Saiesh0007/3DP/Parts.PNG

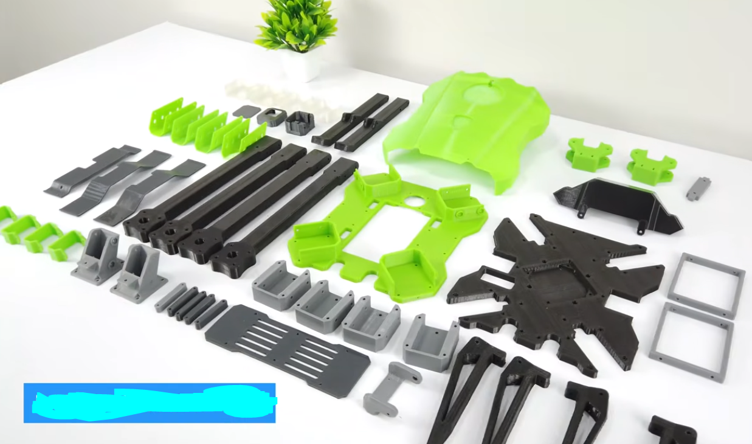
Parts.PNG
