Saiesh0007/3DP/version 6/output/renders/front_corridor.png

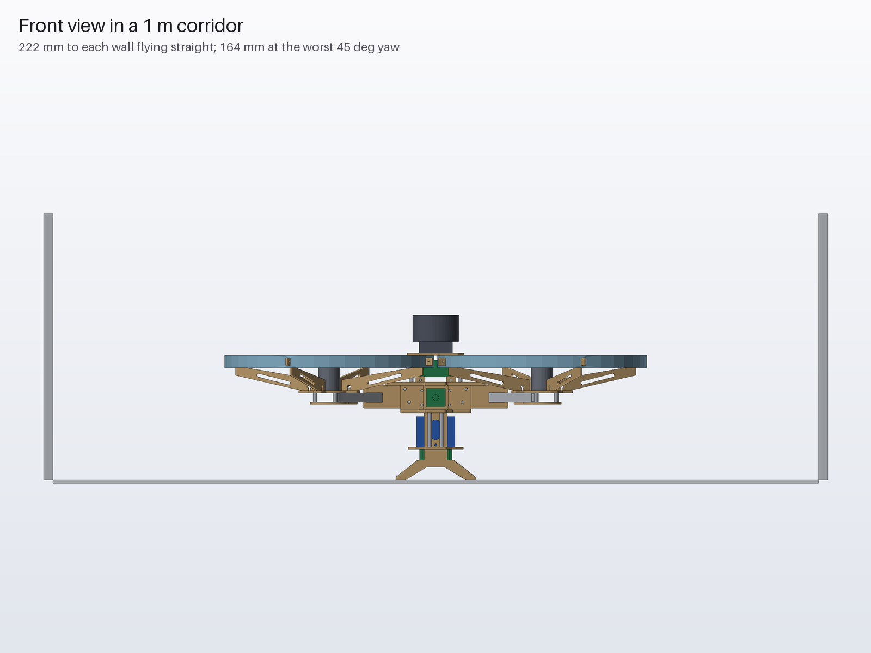
version 6/output/renders/front_corridor.png
