Saiesh0007/3DP/version 2/README.md

# NIDAR AirMouse frame, version 2

Original design for Mission 2 (AirMouse), generated by `generate_frame.py`. Arms fold downward. It is built around a Pixhawk 2.4.8, Raspberry Pi 4B, YDLidar X2, TFmini-S, PX4Flow, Readytosky 2212 920 KV motors, 40 A ESCs and a CNHL 3S 5000 mAh battery.

**Status: not yet printed or flown.** The checks below cover geometry and estimates only. Do the thrust test first: it decides whether this motor and battery setup can carry the drone.

## Rule check

| Rule | Limit | This design |
|---|---|---|
| Launch area (Rulebook 8.23, Brief 9) | 2 ft × 2 ft (610 mm) | 560 mm wide, 49 mm spare |
| Corridor (8.22) | 1 m wide, 8 ft high | 220 mm each side square on; 161 mm each side at the worst 45° yaw |
| Room (8.22) | 2 m × 2 m | Worst-case rotation width is 677 mm |
| All-up weight (Brief 2) | 10 kg | About 2.2 kg |
| Prop guards (8.30) | "fully protect the propeller operating area" | Full ring around each prop. **No top or bottom mesh, so confirm this is accepted** |
| Original airframe (8.2, 10.8) | No ready-made complete airframes | Own design, printed by the team |

Other rules to plan for, which a frame can't solve on its own:

- **Live camera feed (8.27):** your parts list has no camera. The frame has a mount for a Raspberry Pi camera board.
- **Emergency stop and failsafes (8.31):** set these up in the flight software and test them.
- **Fast Completion bonus (25 marks):** the mission must finish within 15 minutes, and the estimated flight time here is about 8.

## Why it can't be much smaller

At 3S, 2212 920 KV motors need 10-inch props to produce useful thrust, and smaller props lift less. Each guard needs 8 mm of clearance around the prop, and the guards can't overlap, so that sets the minimum size.

| | Width, square on | Width at worst yaw | Clearance per side at worst yaw |
|---|---|---|---|
| This frame, 10 in props | 560 mm | 677 mm | 161 mm |
| F450 with the same guards (calculated) | 597 mm | 729 mm | 136 mm |

## The main risk: thrust

| Item | Estimate |
|---|---|
| Printed frame | About 730 g (880 g at most) |
| Your parts, wiring, bolts | About 1470 g |
| All-up weight | About 2.2 kg |
| Thrust-to-weight | **1.17 to 1.55** (aim for 2.0; below about 1.5 is risky) |
| Hover flight time | **About 8 minutes** (80% of battery used) |

The thrust range comes from published figures for this motor size that disagree: a test table gives 642 g per motor on a 1045 prop at 11.1 V, and seller listings claim 850 g or more. The Readytosky motors have no maker's test data that I could find.

**Test before printing the full set.** Measure one motor with a 1045 prop, your ESC and a charged battery, using a kitchen scale and a secured motor. Keep clear of the prop.

| Measured thrust per motor | What it means |
|---|---|
| Under 700 g | Thrust-to-weight is under about 1.3. Don't fly this setup. Change the motors or battery |
| 700-850 g | Marginal. Fly slowly and cut weight |
| Over 850 g | Thrust-to-weight is at least about 1.55. Usable indoors, and more is better |

Ways to improve it:

1. Use stronger motors or a higher-voltage battery. This has the biggest effect, and 4S with smaller props could also shrink the frame, but needs its own thrust test.
2. Weigh your lidar: the datasheet says 200 g, while another listing says 126 g.
3. Drop the upper deck height (`POST_H`) if your wiring allows.

## Parts to print

All parts fit the Ender 3 V3 SE and need no supports. Keep each STL in the position it loads in.

| STL | Qty | Size (mm) | Put on the bed |
|---|---|---|---|
| `arm_A_x2.stl` | 2 | 123 × 119 × 32 | Motor face down |
| `arm_B_x2.stl` | 2 | 123 × 119 × 32 | Motor face down |
| `bottom_deck_x1.stl` | 1 | 181 × 162 × 44 | Flat side down |
| `top_deck_x1.stl` | 1 | 180 × 106 × 3 | Flat |
| `upper_deck_x1.stl` | 1 | 100 × 80 × 63 | Flat, posts up |
| `sensor_mount_x1.stl` | 1 | 108 × 48 × 5 | Flat, recess up |
| `leg_x4.stl` | 4 | 97 × 75 × 16 | Flat, flange up |
| `camera_mount_x1.stl` | 1 | 28 × 28 × 14 | Flat, flange up |
| `guard_arc_x16.stl` | 16 | 42 × 192 × 20 | Standing on its rim |
| `guard_spoke_x16.stl` | 16 | 117 × 48 × 20 | Flat, flanges up |

Arm A goes at front left and rear right. Arm B goes at front right and rear left.

## Slicer settings

| Setting | Arms, bottom deck | Guards | Everything else |
|---|---|---|---|
| Material | PETG | PETG | PETG |
| Layer height | 0.2 mm | 0.2 mm | 0.2 mm |
| Walls | 5 lines | 3 lines | 4 lines |
| Infill | 30% gyroid | 100% | 30% gyroid |
| Supports | Off | Off | Off |
| Brim | 5 mm on arms | 5 mm on arcs | Only if corners lift |

## Hardware

| Use | Hardware | Qty |
|---|---|---|
| Arm hinge and lock | M4 × 35 + nyloc nut | 8 |
| Deck bolts | M3 × 50 + plain nut with threadlocker (the stack is 46.6 mm, too long for a nyloc on a 50 mm bolt) | 12 |
| Upper deck posts | M3 × 70 + nyloc nut | 4 |
| Legs | M3 × 12 + washer + nyloc nut | 8 |
| Guard spoke to arm | M3 × 10 + nyloc nut | 32 |
| Guard arc to spoke | M3 × 10 + nut | 32 |
| Motors | M3, 4 per motor, short enough to stop clear of the windings | 16 |
| Sensor mount | M3 × 10 + nyloc nut | 4 |
| Camera mount | M3 × 10 + nut | 2 |
| YDLidar X2 | M2.5, length to suit its standoffs | 3 |
| Raspberry Pi | M2.5 × 8 | 4 |
| TFmini-S | M2 × 8 | 2 |
| PX4Flow, Pixhawk | Zip ties, foam tape | |

## Where each part goes

| Part | Location |
|---|---|
| Battery | In the bay, on a 3 mm foam pad. Strap through the deck slots |
| Pixhawk 2.4.8 | Centre of the top deck, on anti-vibration foam, with zip-tie slots around it |
| Raspberry Pi 4B | Under the upper deck, on the built-in standoffs |
| YDLidar X2 | On top of the upper deck. Scan plane about 152 mm above the deck, 69 mm above the guards |
| TFmini-S | Sensor mount, rear position, lenses down |
| PX4Flow | Sensor mount, front position, in the recess, lens down, held by zip ties |
| ESCs | On top of each arm, zip-tied |
| Camera | Front of the top deck, facing forward |

Enter the true sensor positions in the flight controller settings, because the sensors sit off-centre. The TFmini-S can't read below 10 cm, and sits about 54 mm off the ground when landed, so its reading is invalid until the drone climbs. Set the flight controller's minimum-range setting to match.

## Folding

1. Remove the lock bolt on each arm (the upper, outer bolt). Leave the hinge bolt in.
2. Swing the arm down.
3. To open, swing it up until it stops against the wall, then refit the lock bolt.

Folded size is 554 × 272 × 312 mm. Leave enough wire slack at each hinge for 90° of movement, or the wires will fatigue. Check all four lock bolts before every flight.

Thrust pushes the arm against a solid stop wall, so the lock bolt doesn't carry flight loads. It stops the arm folding on the ground or in a bump.

## Measure these before printing the full set

| Item | Assumed | Source | Parameter |
|---|---|---|---|
| Motor bolt holes | 16 mm and 19 mm | Common for this motor type, not confirmed for yours | `MOTOR_HOLES` |
| Pad top to prop height | 38 mm | Estimate; the guard band allows about ±8 mm | `PROP_Z_ABOVE_PAD` |
| Battery size | Up to 165 × 50 × 38 mm | No published size found for your pack | `BATTERY` |
| PX4Flow | 45.5 × 35 mm; lens at centre | PX4 docs for size; hole spacing not found, so it uses zip ties | `PX4FLOW` |
| X2 scan height | 42 mm above its base | Scaled from the datasheet drawing | `X2_SCAN_ABOVE_BASE` |
| ESC, prop, flow, wiring masses | See `MASSES` | Assumed | `MASSES` |

Pixhawk size came from retailer listings that vary slightly (width 45.3 to 50 mm). X2 hole positions and TFmini-S spacing come from their datasheet drawings.

## Check results

Run `python generate_frame.py` for current results. All checks pass:

- All 10 STLs are watertight when re-read from disk, and fit the bed.
- Arms, guards and motors clear each other, the body and the legs, deployed, folded and at 9 positions through the fold with all four arms moving together.
- The arm can't rotate upward past its stop wall.
- 10 inch props clear the guards, arms and body.
- The X2 scan plane is above the guards and motors, and the downward sensors see past the legs.
- Hinge, leg, deck, sensor, camera and guard bolt holes line up.

Not modelled or tested: real strength, layer adhesion, vibration, crash loads, airflow under the deck, and thrust lost near the guards. The camera lens view, wiring routes and bolt heads aren't checked either.

## Test order

1. Thrust test on one motor (see above).
2. Print one arm A, one guard set and the bottom deck. Check fit, hinge motion and lock bolt.
3. Clamp the deck and hang 2 kg from the motor pad for 5 minutes. Look for cracks or bending.
4. Print the rest. Weigh everything and update `MASSES`.
5. Run motors with props off, and check for loose bolts.
6. Tie the drone down loosely for a first hover test in an open space with a tested emergency stop. Check the vibration logs, especially for the X2 on its tall posts.

Rule 8.5 bans tethers during the mission itself; a tether is only for your own testing.
