Saiesh0007/3DP/Folded.PNG

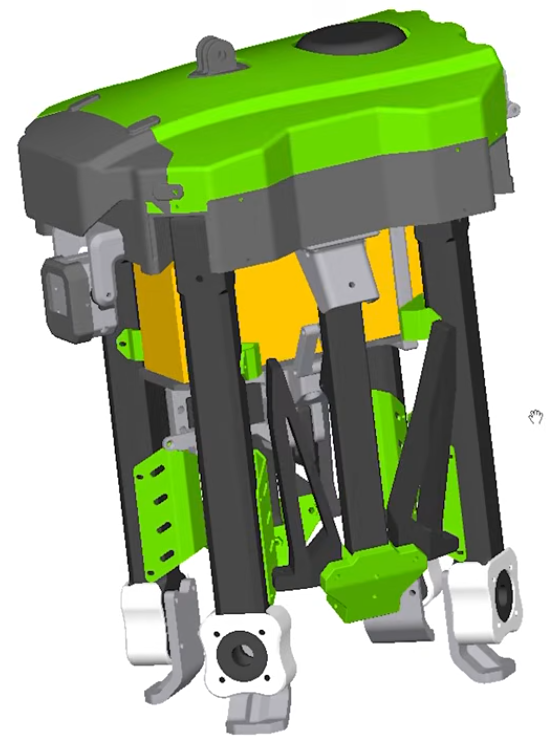
Folded.PNG
