Saiesh0007/3DP/Front View 2.PNG

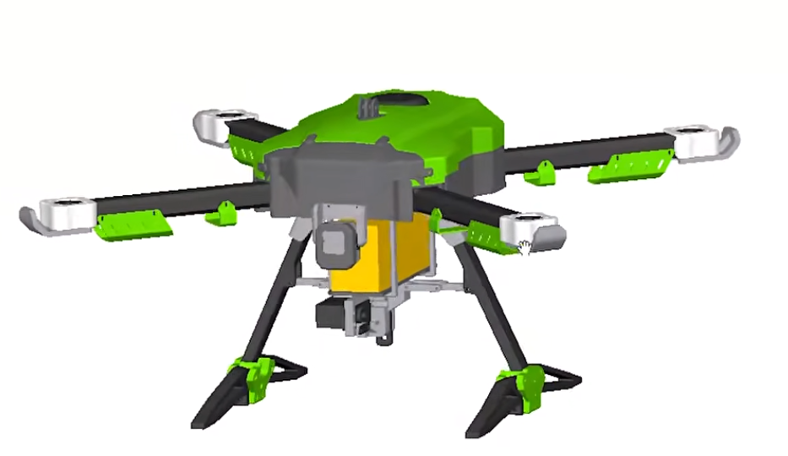
Front View 2.PNG
