Saiesh0007/3DP/Front View.PNG

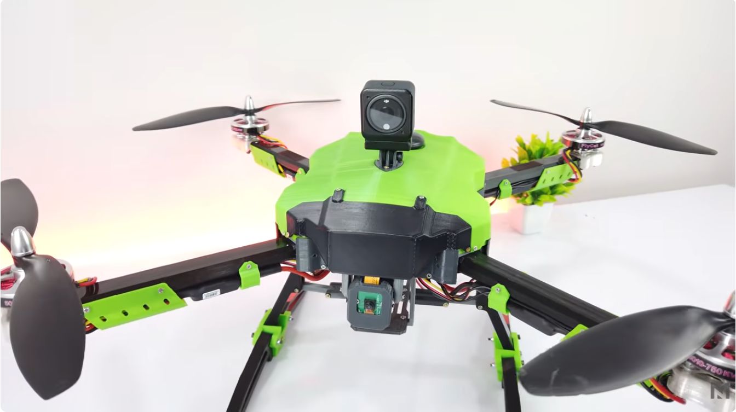
Front View.PNG
