Saiesh0007/3DP/Top View 2.PNG

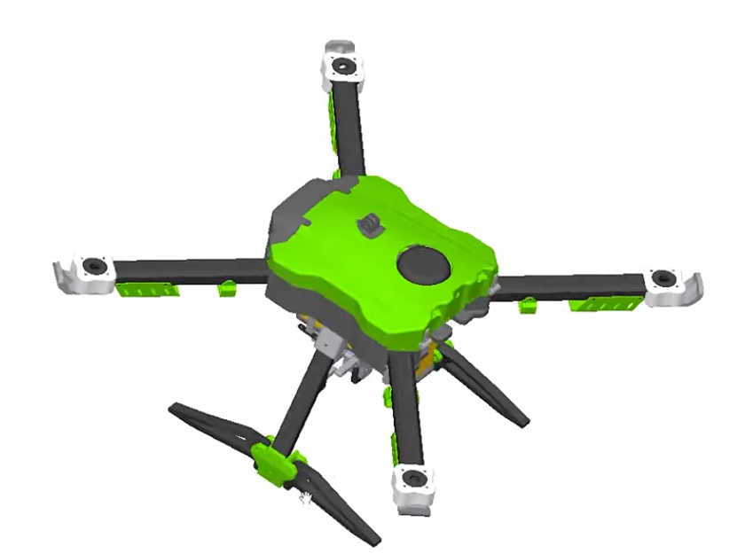
Top View 2.PNG
