Saiesh0007/3DP/Top View.PNG

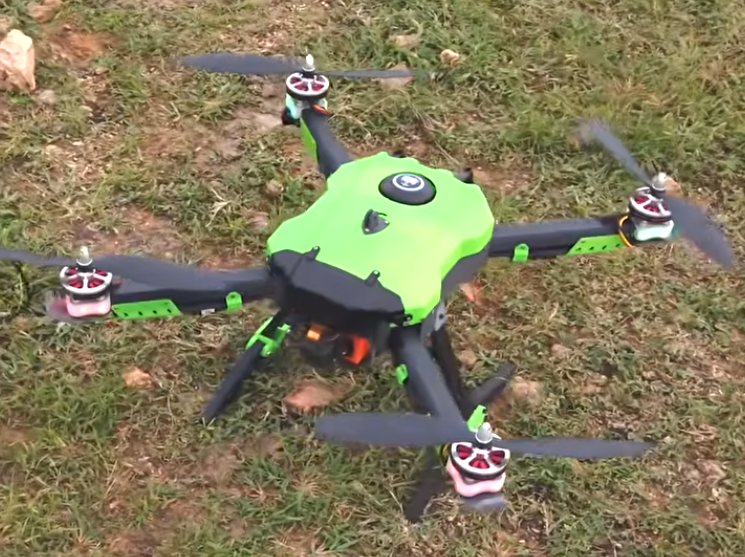
Top View.PNG
