Saiesh0007/3DP/version 6/output/renders/arm_hinge.png

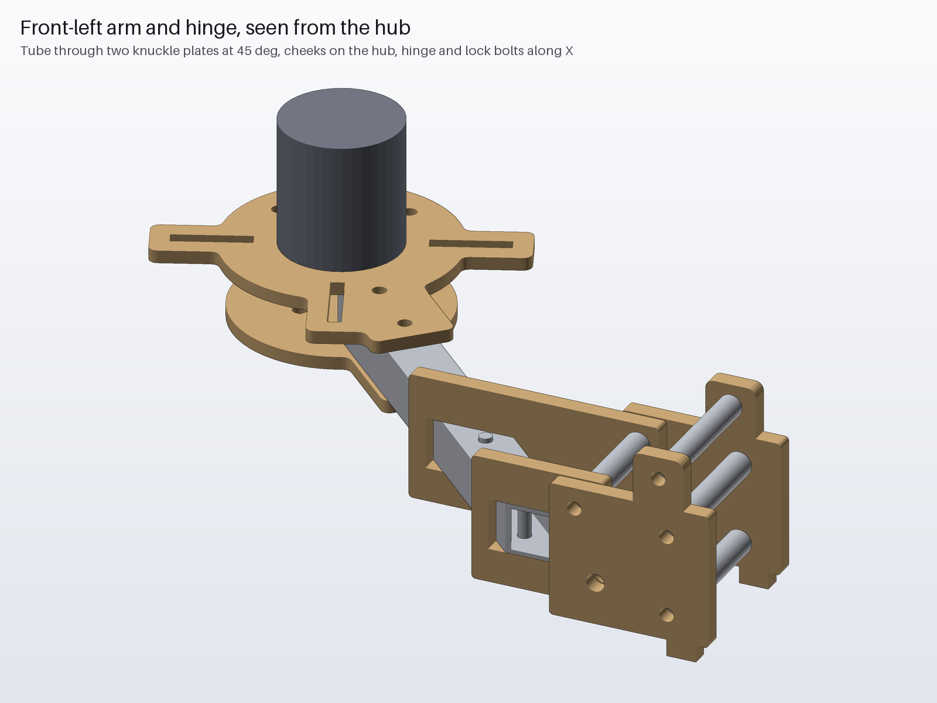
version 6/output/renders/arm_hinge.png
