Saiesh0007/3DP/version 6/output/renders/cut_sheet_3mm.png

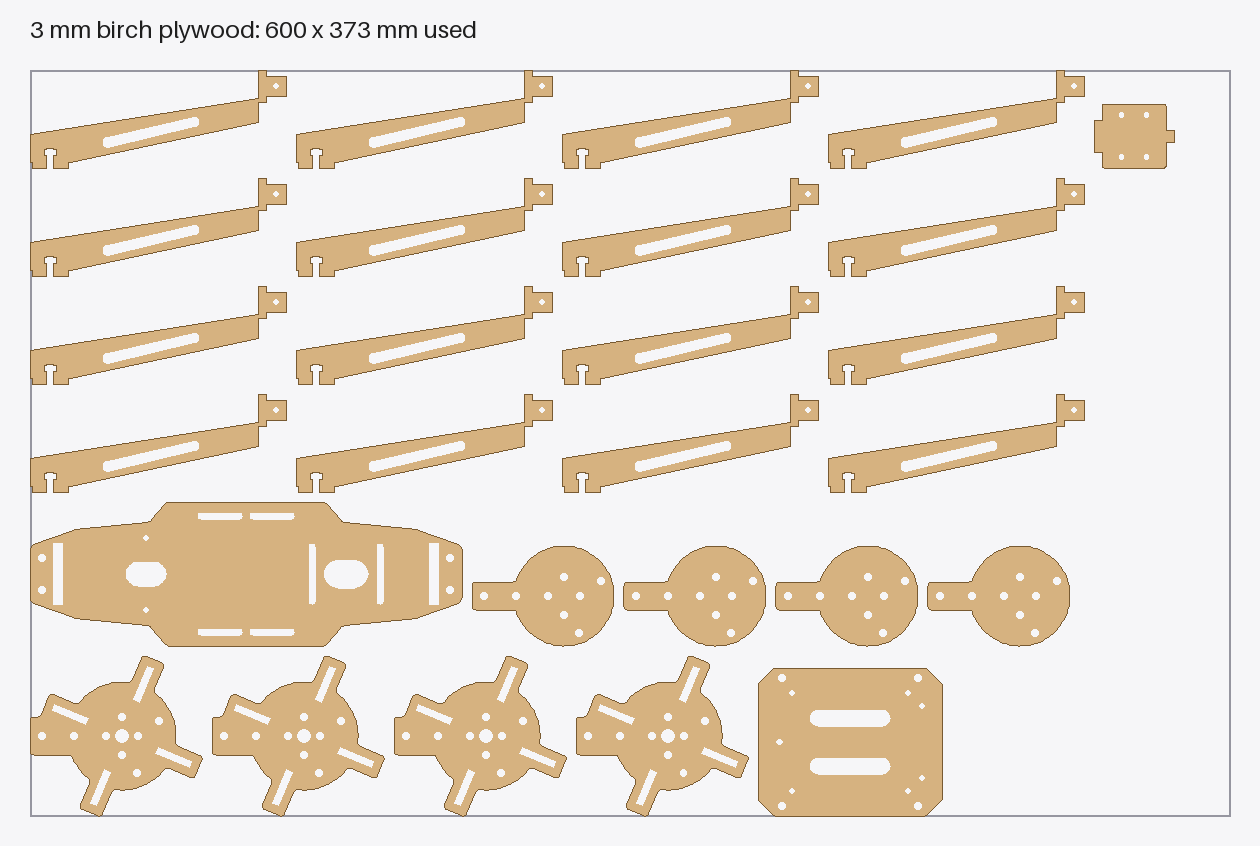
version 6/output/renders/cut_sheet_3mm.png
