Saiesh0007/3DP/version 6/output/renders/cut_sheet_4mm.png

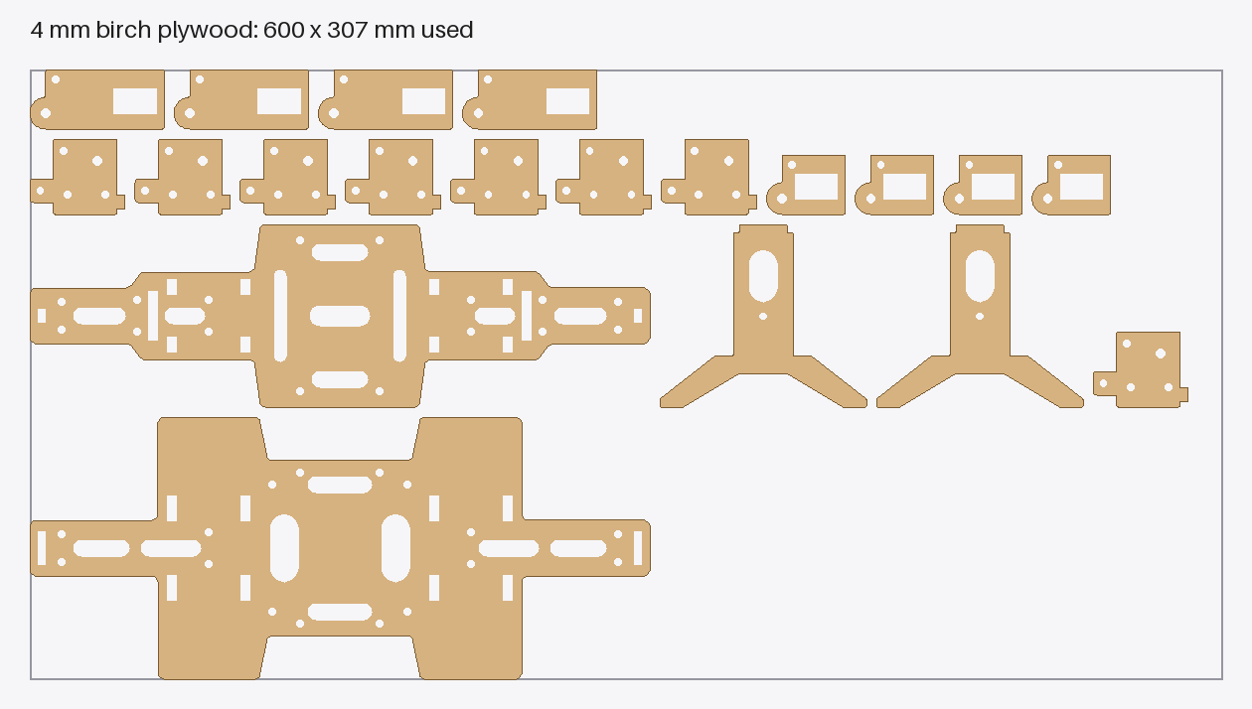
version 6/output/renders/cut_sheet_4mm.png
