Saiesh0007/3DP/version 6/output/renders/deployed.png

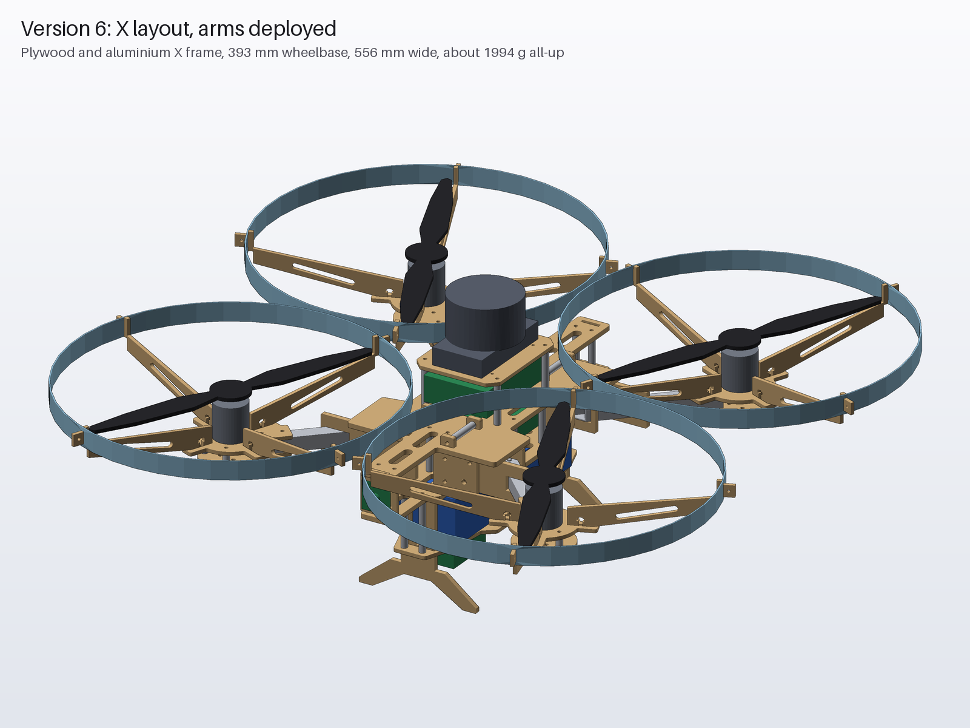
version 6/output/renders/deployed.png
