Saiesh0007/3DP/version 6/output/renders/exploded.png

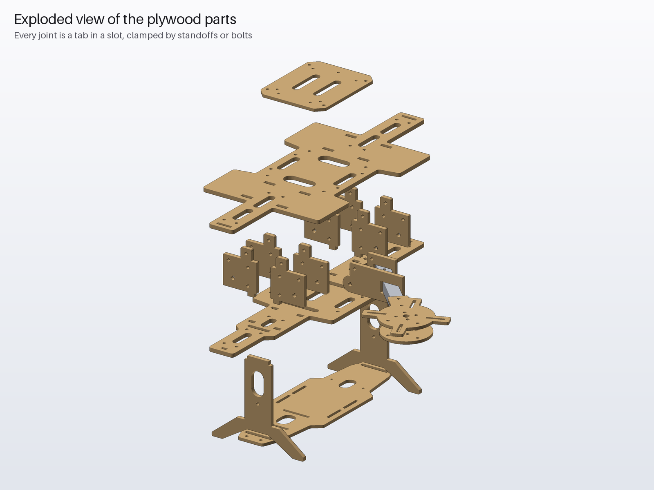
version 6/output/renders/exploded.png
