Saiesh0007/3DP/version 6/output/renders/fold_sequence.png

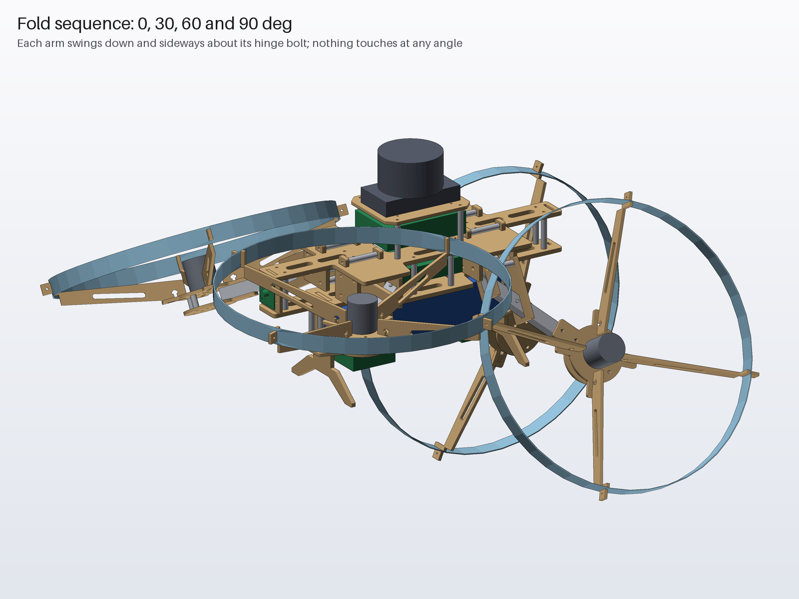
version 6/output/renders/fold_sequence.png
