Saiesh0007/3DP/version 6/output/renders/folded.png

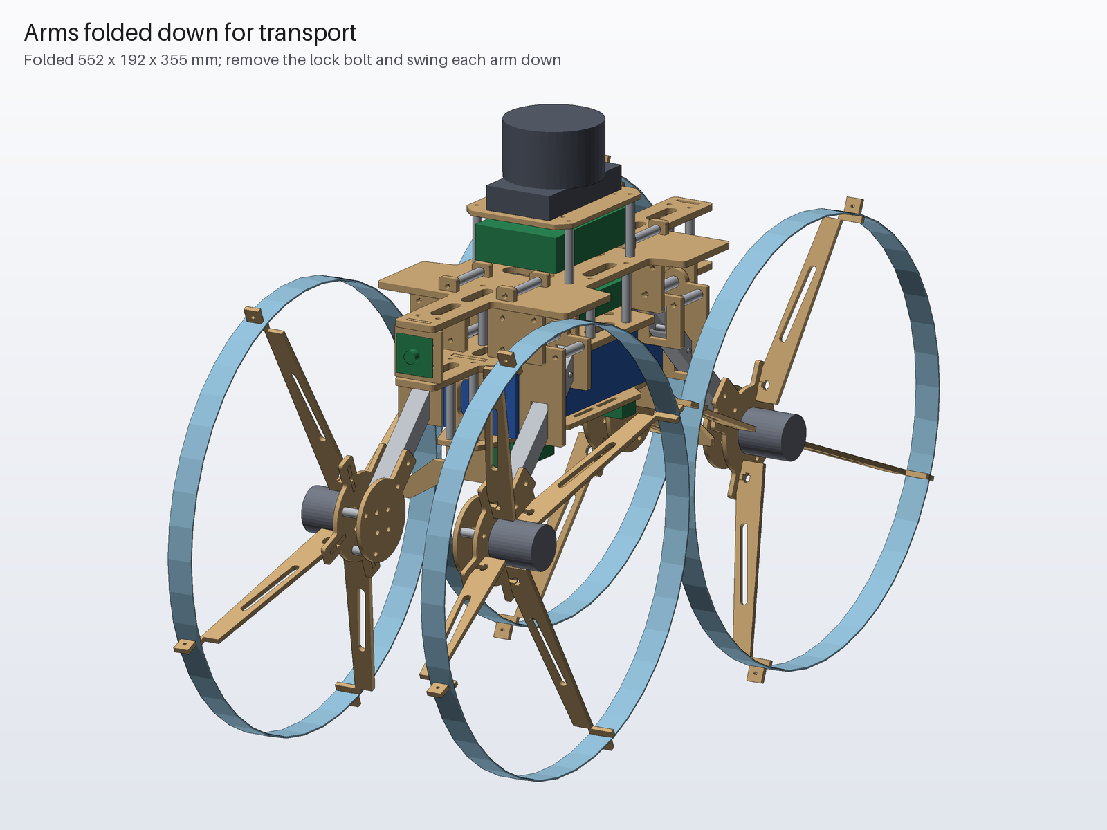
version 6/output/renders/folded.png
