Saiesh0007/3DP/version 6/output/renders/top.png

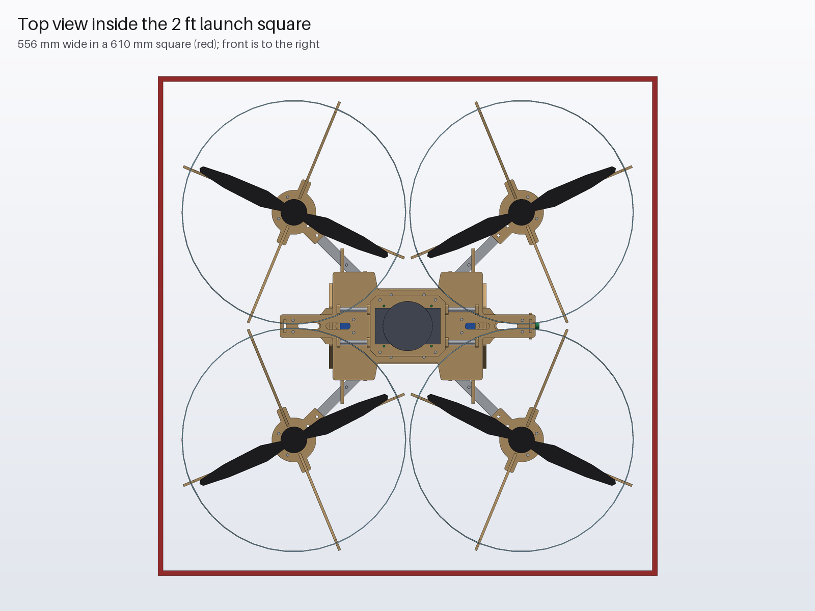
version 6/output/renders/top.png
