Saiesh0007/3DP/version 6/output/step/assembly_folded.step

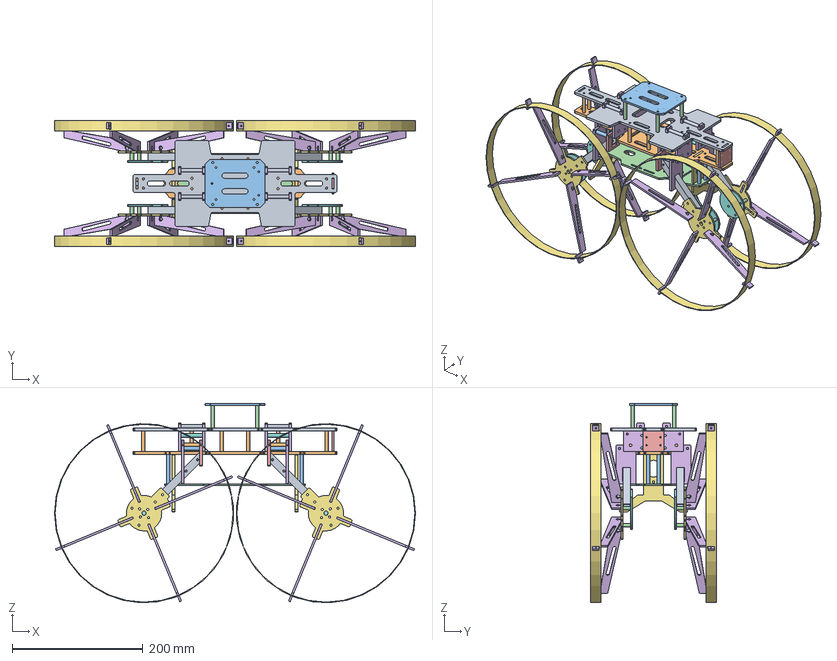
[picture p16: CAD file, 2026-11-10]
version 6/output/step/assembly_folded.step
552.0 x 192.0 x 304.8 mm
