Saiesh0007/3DP/version 6/output/step/assembly_deployed.step

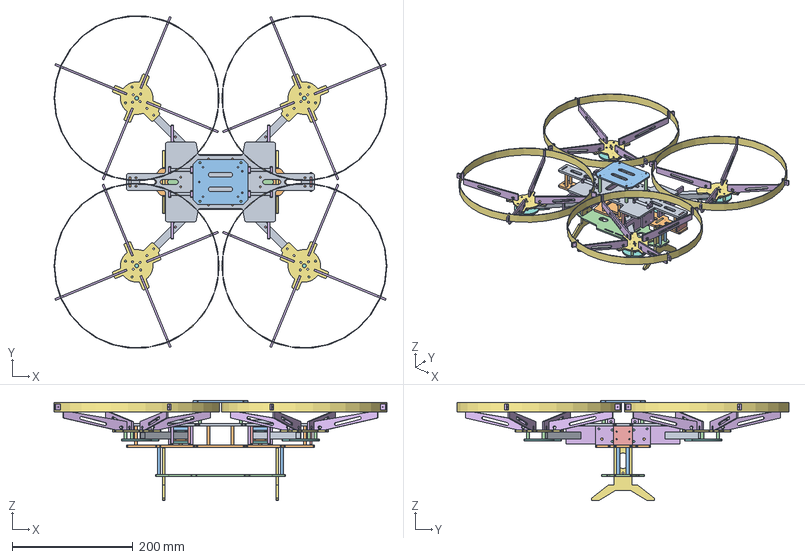
[picture p17: CAD file, 2026-11-10]
version 6/output/step/assembly_deployed.step
552.0 x 550.5 x 166.0 mm
