Saiesh0007/3DP/version 6/output/dxf/CUT_SHEET_4mm.dxf

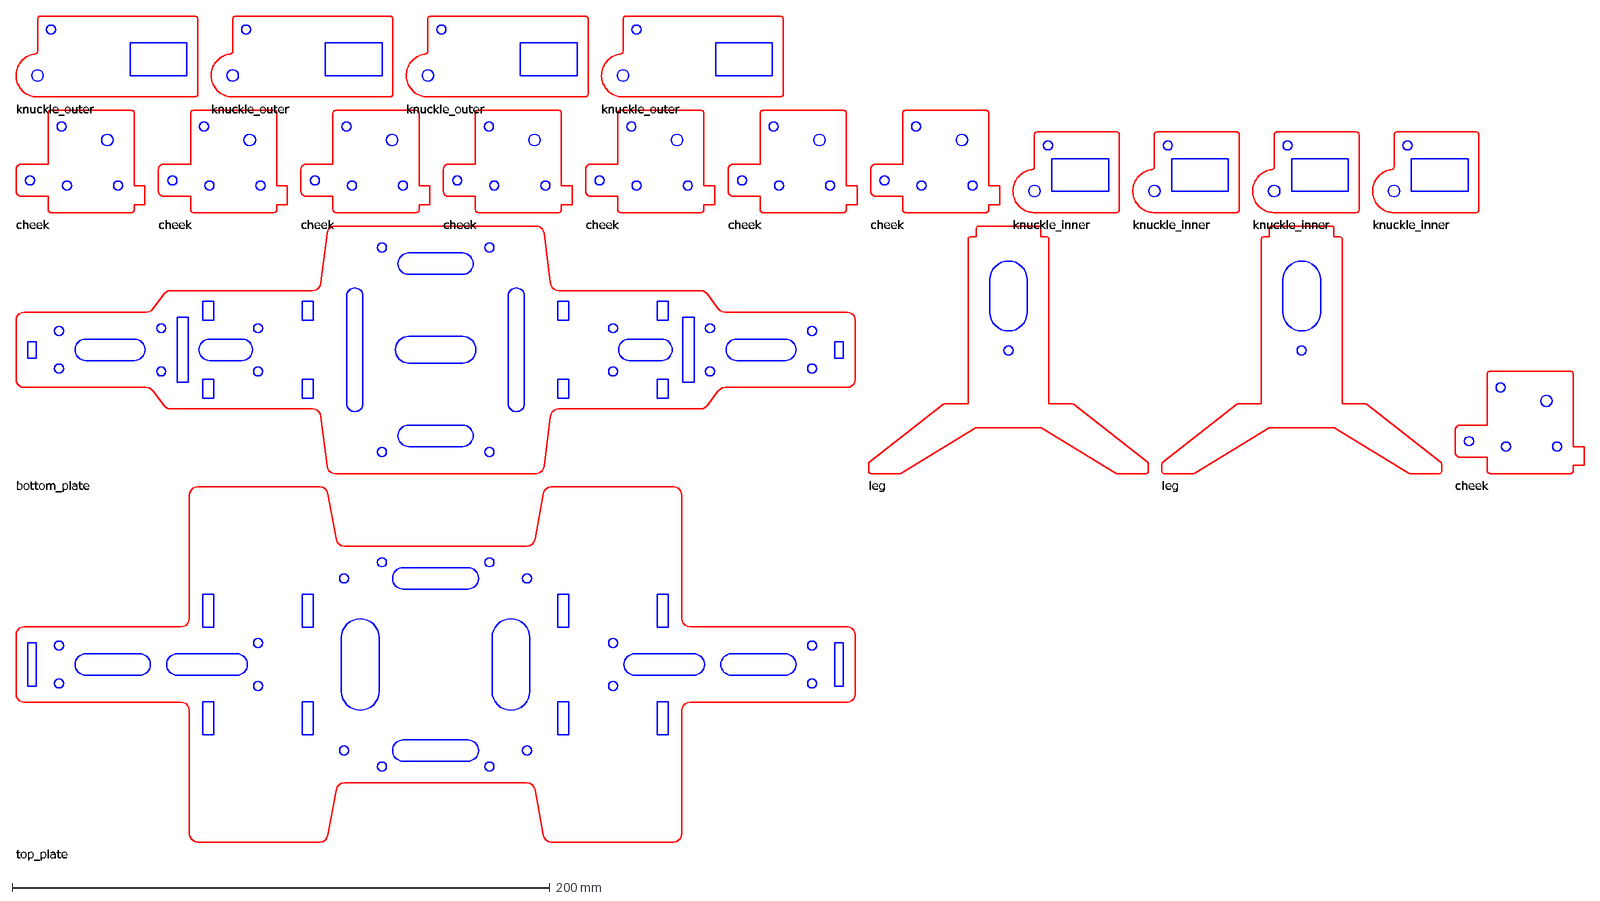
[picture p18: CAD file, 2026-11-10]
version 6/output/dxf/CUT_SHEET_4mm.dxf
top_plate
bottom_plate
leg
cheek
knuckle_inner
knuckle_outer
