Saiesh0007/3DP/version 6/output/step/arm_tube_x4.step

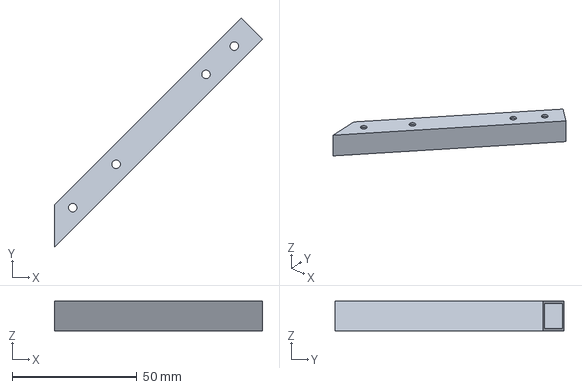
[picture p19: CAD file, 2026-11-10]
version 6/output/step/arm_tube_x4.step
83.3 x 91.8 x 12.0 mm
