Saiesh0007/3DP/version 6/output/dxf/CUT_SHEET_3mm.dxf

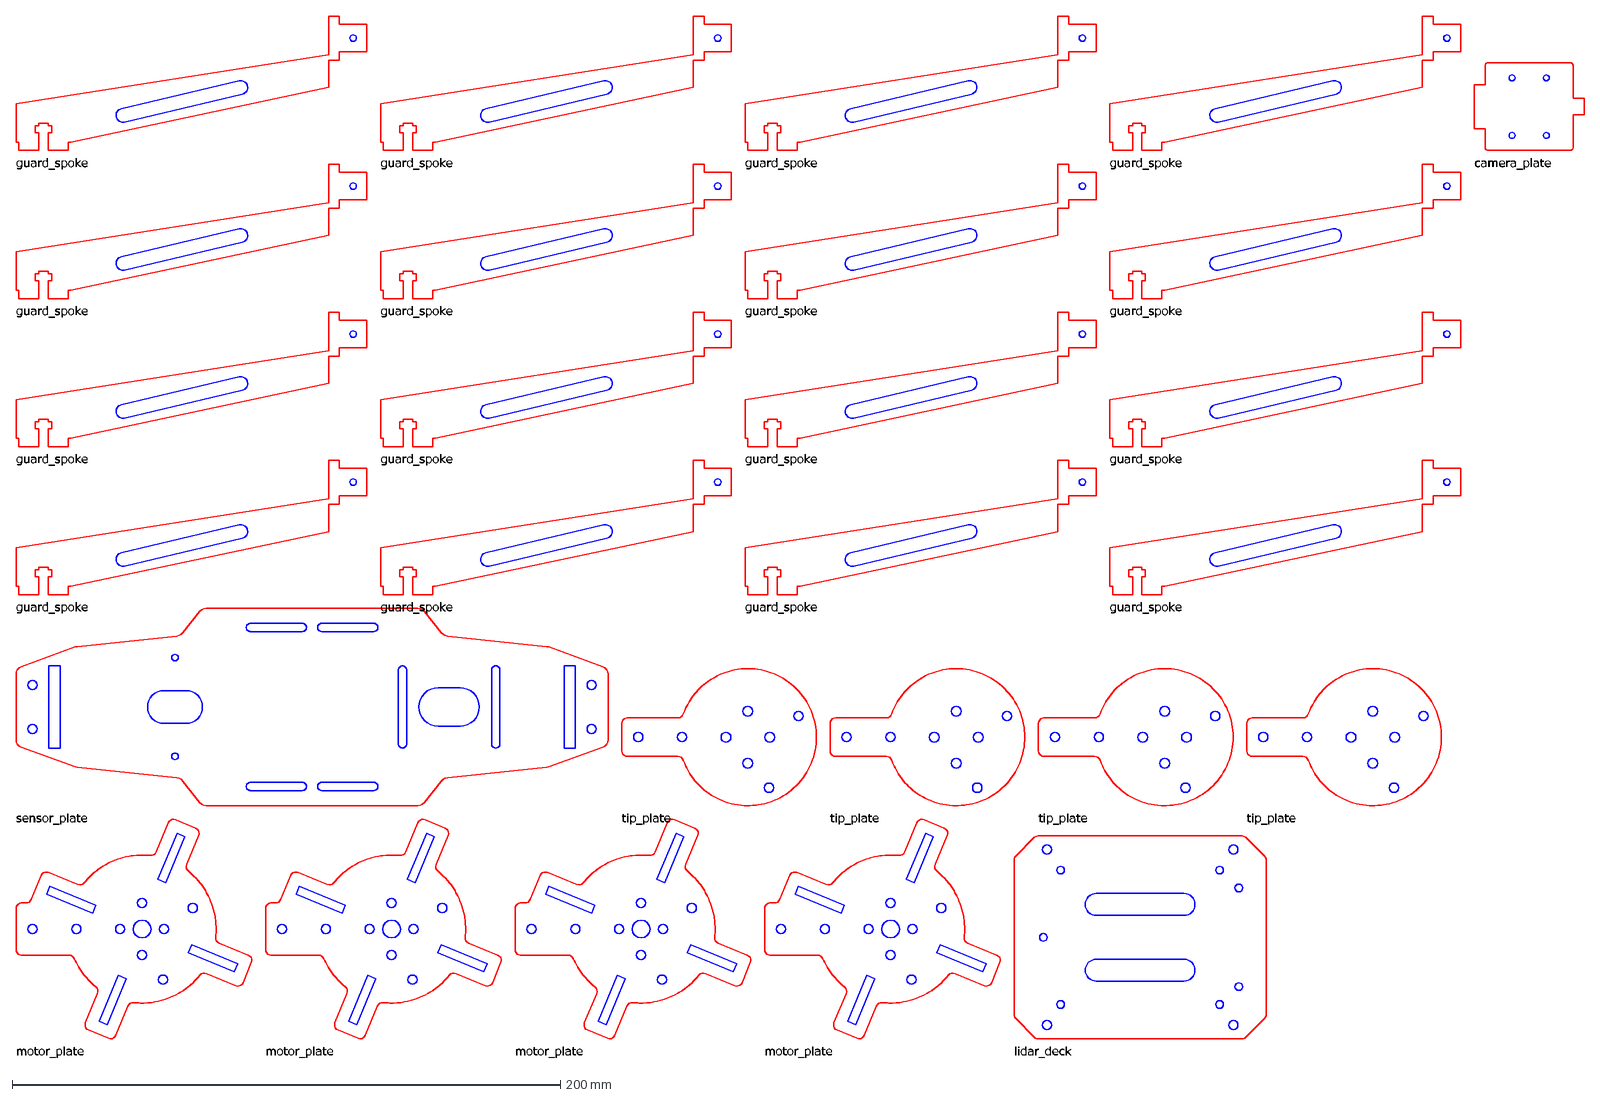
[picture p20: CAD file, 2026-11-10]
version 6/output/dxf/CUT_SHEET_3mm.dxf
motor_plate
lidar_deck
sensor_plate
tip_plate
guard_spoke
camera_plate
