Saiesh0007/3DP/version 6/output/step/lidar_deck_3mm_x1.step

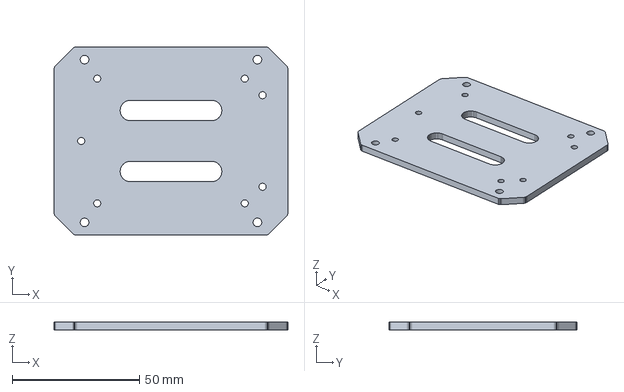
[picture p21: CAD file, 2026-11-10]
version 6/output/step/lidar_deck_3mm_x1.step
92.0 x 74.0 x 3.00 mm
