Saiesh0007/3DP/version 6/output/step/knuckle_outer_4mm_x4.step

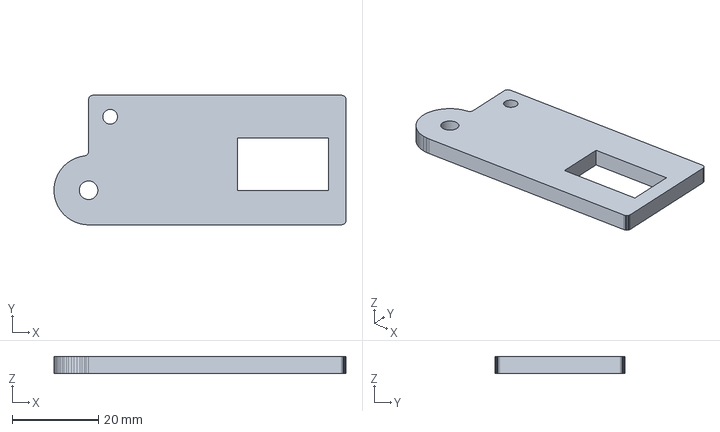
[picture p22: CAD file, 2026-11-10]
version 6/output/step/knuckle_outer_4mm_x4.step
67.6 x 30.0 x 4.00 mm
