Saiesh0007/3DP/version 6/output/step/guard_band_x4.step

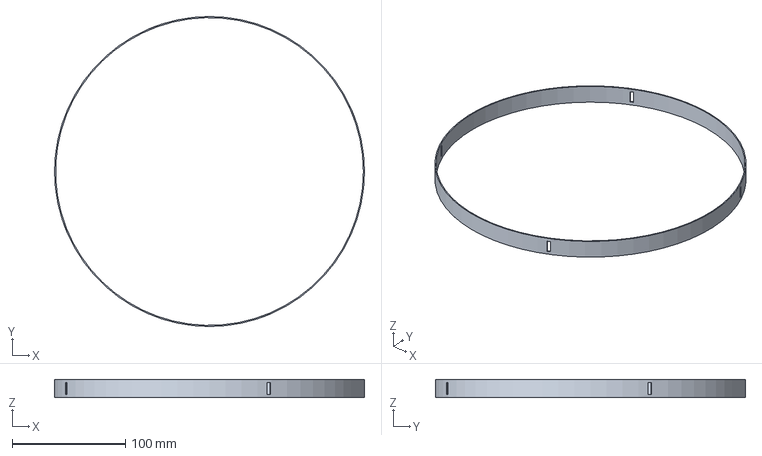
[picture p23: CAD file, 2026-11-10]
version 6/output/step/guard_band_x4.step
274.0 x 274.0 x 16.0 mm
