Saiesh0007/3DP/version 6/output/step/leg_4mm_x2.step

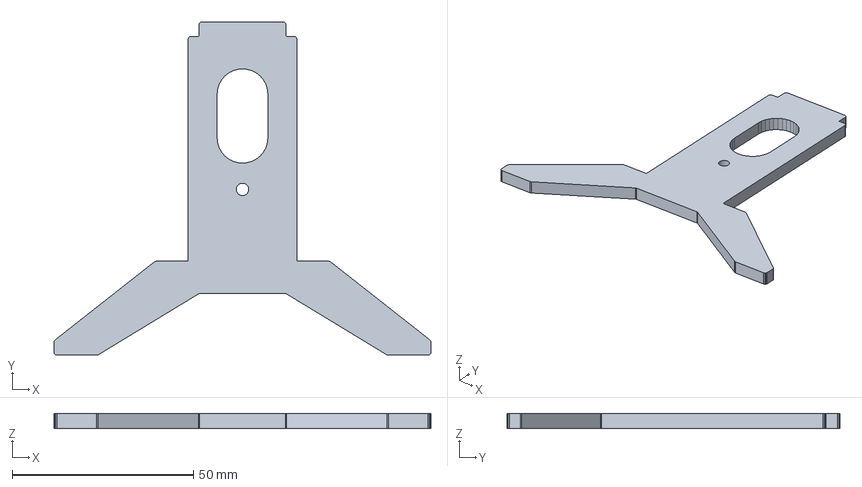
[picture p24: CAD file, 2026-11-10]
version 6/output/step/leg_4mm_x2.step
104.0 x 92.0 x 4.00 mm
