Saiesh0007/3DP/version 6/output/step/tip_plate_3mm_x4.step

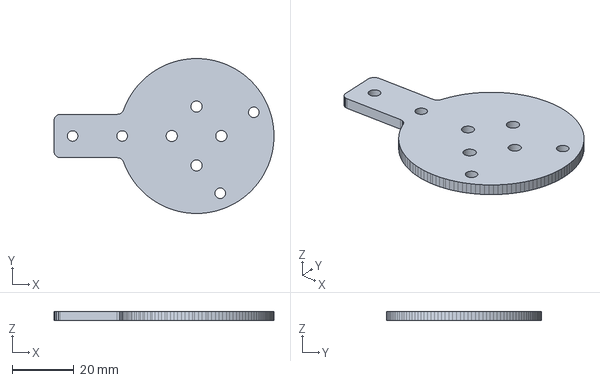
[picture p25: CAD file, 2026-11-10]
version 6/output/step/tip_plate_3mm_x4.step
71.0 x 50.0 x 3.00 mm
