Saiesh0007/3DP/version 6/output/step/guard_spoke_3mm_x16.step

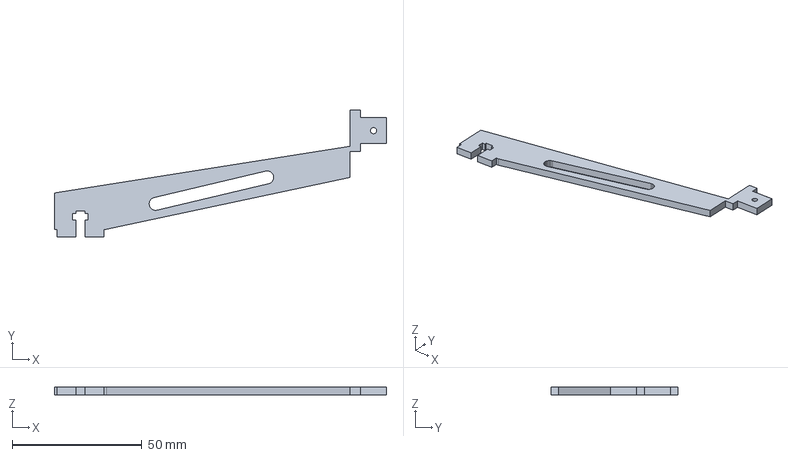
[picture p26: CAD file, 2026-11-10]
version 6/output/step/guard_spoke_3mm_x16.step
128.0 x 49.0 x 3.00 mm
