Saiesh0007/3DP/version 6/output/step/sensor_plate_3mm_x1.step

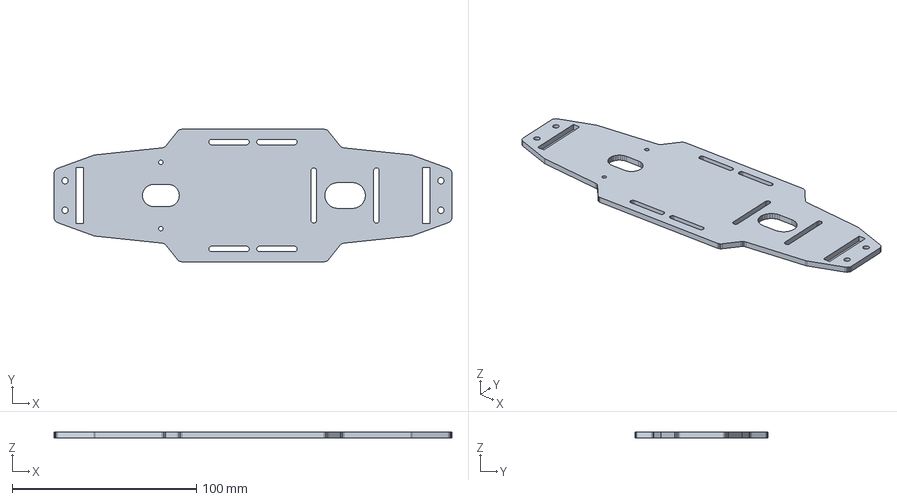
[picture p27: CAD file, 2026-11-10]
version 6/output/step/sensor_plate_3mm_x1.step
216.0 x 72.0 x 3.00 mm
