Saiesh0007/3DP/version 6/output/step/bottom_plate_4mm_x1.step

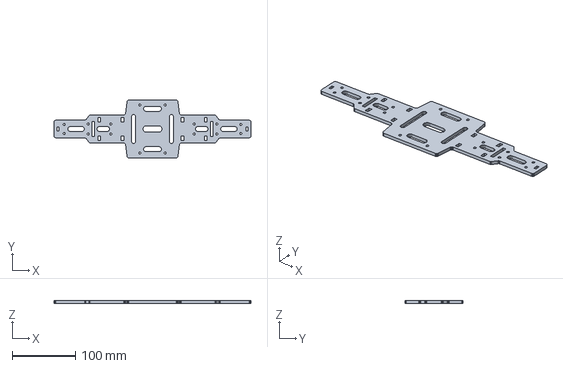
[picture p28: CAD file, 2026-11-10]
version 6/output/step/bottom_plate_4mm_x1.step
312.0 x 92.0 x 4.00 mm
