Saiesh0007/3DP/version 6/output/step/motor_plate_3mm_x4.step

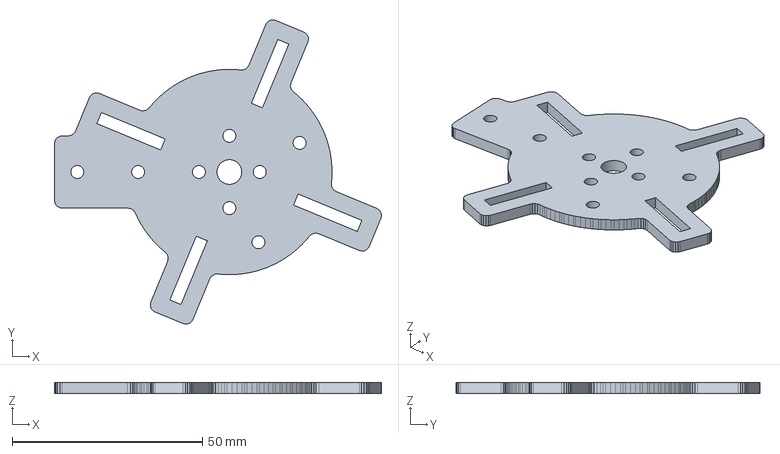
[picture p29: CAD file, 2026-11-10]
version 6/output/step/motor_plate_3mm_x4.step
86.0 x 80.0 x 3.00 mm
