Saiesh0007/3DP/version 6/output/step/top_plate_4mm_x1.step

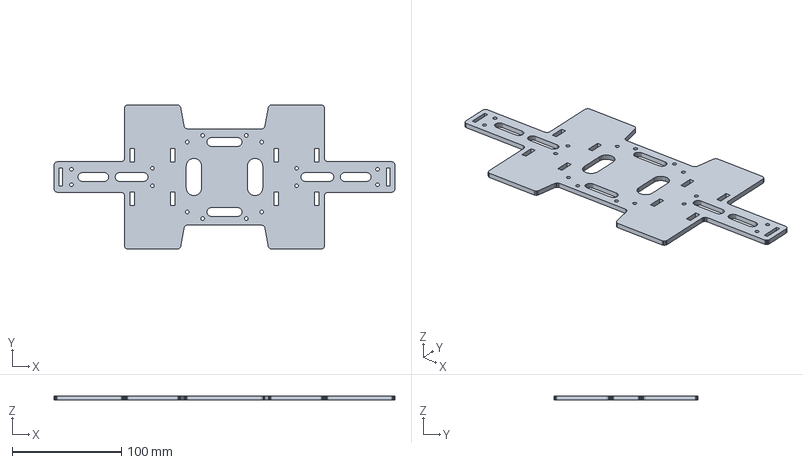
[picture p30: CAD file, 2026-11-10]
version 6/output/step/top_plate_4mm_x1.step
312.0 x 132.0 x 4.00 mm
