Saiesh0007/3DP/version 6/output/step/camera_plate_3mm_x1.step

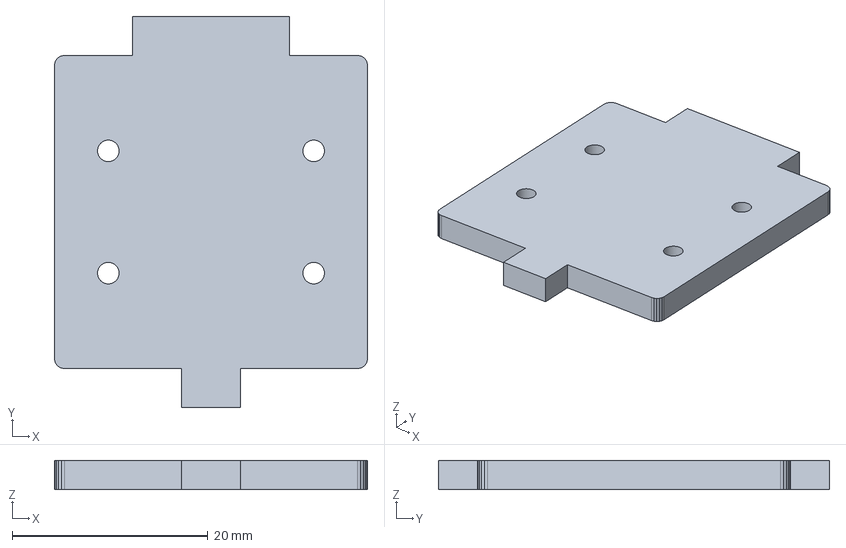
[picture p31: CAD file, 2026-11-10]
version 6/output/step/camera_plate_3mm_x1.step
32.0 x 40.0 x 3.00 mm
