Saiesh0007/3DP/version 6/output/step/cheek_4mm_x8.step

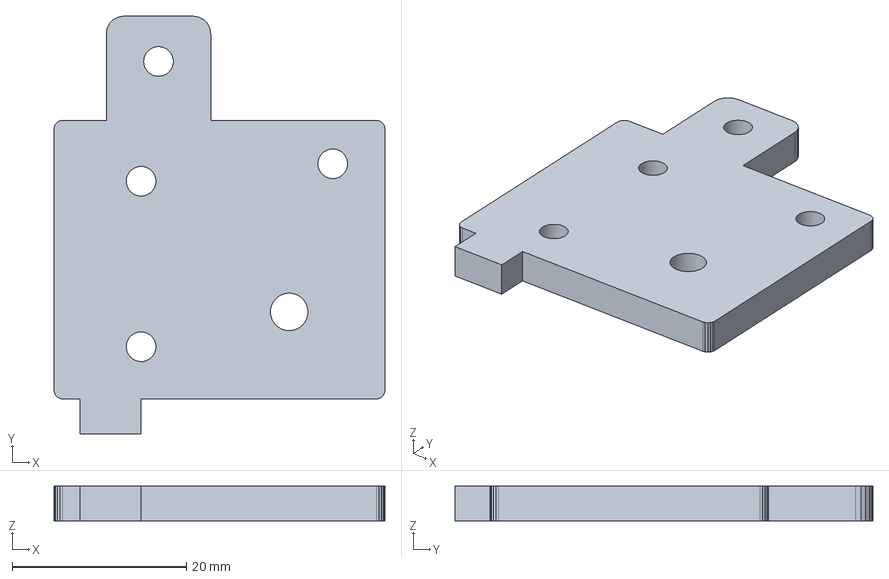
[picture p32: CAD file, 2026-11-10]
version 6/output/step/cheek_4mm_x8.step
38.0 x 48.0 x 4.00 mm
