Saiesh0007/3DP/version 6/output/step/knuckle_inner_4mm_x4.step

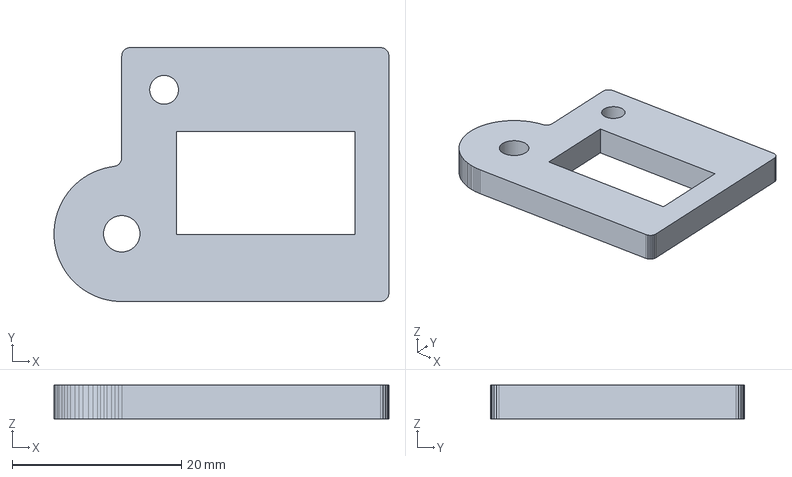
[picture p33: CAD file, 2026-11-10]
version 6/output/step/knuckle_inner_4mm_x4.step
39.6 x 30.0 x 4.00 mm
