Saiesh0007/3DP/(list of files, cad)

Other CAD files:
version 6/output/dxf/guard_band_polycarbonate_x4.dxf
version 1/step/arm_x4.step
version 1/step/assembly_deployed.step
version 1/step/bottom_plate_x1.step
version 1/step/canopy_x1.step
version 1/step/landing_hoop_x2.step
version 1/step/top_plate_x1.step
version 1/stl/arm_x4.stl
version 1/stl/bottom_plate_x1.stl
version 1/stl/canopy_x1.stl
version 1/stl/landing_hoop_x2.stl
version 1/stl/top_plate_x1.stl
version 2/step/arm_A_x2.step
version 2/step/arm_B_x2.step
version 2/step/assembly_deployed.step
version 2/step/bottom_deck_x1.step
version 2/step/camera_mount_x1.step
version 2/step/guard_arc_x16.step
version 2/step/guard_spoke_x16.step
version 2/step/leg_x4.step
version 2/step/sensor_mount_x1.step
version 2/step/top_deck_x1.step
version 2/step/upper_deck_x1.step
version 2/stl/arm_A_x2.stl
version 2/stl/arm_B_x2.stl
version 2/stl/bottom_deck_x1.stl
version 2/stl/camera_mount_x1.stl
version 2/stl/guard_arc_x16.stl
version 2/stl/guard_spoke_x16.stl
version 2/stl/leg_x4.stl
version 2/stl/sensor_mount_x1.stl
version 2/stl/top_deck_x1.stl
version 2/stl/upper_deck_x1.stl
version 3/output/zd550_arm.step
version 3/output/zd550_arm_cut_sheet.dxf
version 3/output/zd550_bottom_plate.dxf
version 3/output/zd550_bottom_plate.step
version 3/output/zd550_motor_mount.dxf
version 3/output/zd550_motor_mount.step
version 3/output/zd550_top_plate.dxf
version 3/output/zd550_top_plate.step
version 4/output/dxf/bottom_plate.dxf
version 4/output/dxf/top_plate.dxf
version 4/output/step/arm_root_A_x2.step
version 4/output/step/arm_root_B_x2.step
version 4/output/step/arm_tube_x4_BUY.step
version 4/output/step/assembly_deployed.step
version 4/output/step/battery_tray_x1.step
version 4/output/step/bottom_plate_x1.step
version 4/output/step/guard_arc_x16.step
version 4/output/step/guard_spoke_x16.step
version 4/output/step/hinge_base_A_x2.step
version 4/output/step/hinge_base_B_x2.step
version 4/output/step/leg_A_x2.step
version 4/output/step/leg_B_x2.step
version 4/output/step/lidar_deck_x1.step
version 4/output/step/motor_mount_x4.step
version 4/output/step/top_plate_x1.step
version 4/output/stl/arm_root_A_x2.stl
version 4/output/stl/arm_root_B_x2.stl
version 4/output/stl/battery_tray_x1.stl
version 4/output/stl/bottom_plate_x1.stl
version 4/output/stl/guard_spoke_x16.stl
version 4/output/stl/hinge_base_A_x2.stl
version 4/output/stl/hinge_base_B_x2.stl
version 4/output/stl/leg_A_x2.stl
version 4/output/stl/leg_B_x2.stl
version 4/output/stl/lidar_deck_x1.stl
version 4/output/stl/motor_mount_x4.stl
version 4/output/stl/top_plate_x1.stl
version 5/output/dxf/CUT_SHEET_2mm.dxf
version 5/output/dxf/CUT_SHEET_3mm.dxf
version 5/output/dxf/arm_side_3mm_x8.dxf
version 5/output/dxf/bottom_plate_3mm_x1.dxf
version 5/output/dxf/camera_plate_2mm_x1.dxf
version 5/output/dxf/cheek_3mm_x4.dxf
version 5/output/dxf/leg_3mm_x2.dxf
version 5/output/dxf/lidar_deck_2mm_x1.dxf
version 5/output/dxf/motor_plate_2mm_x4.dxf
version 5/output/dxf/sensor_plate_2mm_x1.dxf
version 5/output/dxf/tip_plate_2mm_x4.dxf
version 5/output/dxf/top_plate_3mm_x1.dxf
version 5/output/step/arm_side_3mm_x8.step
version 5/output/step/assembly_deployed.step
version 5/output/step/assembly_folded.step
version 5/output/step/bottom_plate_3mm_x1.step
version 5/output/step/camera_plate_2mm_x1.step
version 5/output/step/cheek_3mm_x4.step
version 5/output/step/guard_arc_x16.step
version 5/output/step/guard_spoke_x16.step
version 5/output/step/leg_3mm_x2.step
version 5/output/step/lidar_deck_2mm_x1.step
version 5/output/step/motor_plate_2mm_x4.step
version 5/output/step/sensor_plate_2mm_x1.step
version 5/output/step/tip_plate_2mm_x4.step
version 5/output/step/top_plate_3mm_x1.step
version 5/output/stl/guard_arc_x16.stl
version 5/output/stl/guard_spoke_x16.stl
version 6/output/dxf/bottom_plate_4mm_x1.dxf
version 6/output/dxf/camera_plate_3mm_x1.dxf
version 6/output/dxf/cheek_4mm_x8.dxf
version 6/output/dxf/guard_spoke_3mm_x16.dxf
version 6/output/dxf/knuckle_inner_4mm_x4.dxf
version 6/output/dxf/knuckle_outer_4mm_x4.dxf
version 6/output/dxf/leg_4mm_x2.dxf
version 6/output/dxf/lidar_deck_3mm_x1.dxf
version 6/output/dxf/motor_plate_3mm_x4.dxf
version 6/output/dxf/sensor_plate_3mm_x1.dxf
version 6/output/dxf/tip_plate_3mm_x4.dxf
version 6/output/dxf/top_plate_4mm_x1.dxf
