Saiesh0007/3DP/(commit log)

2026-11-04 Add NIDAR AirMouse drone frame builds and references
    version 1: 600 mm lateral-fold frame.
    version 2: AirMouse frame with downward-folding arms and prop guards, with generator script, STLs, renders and build guide.
    Also includes the NIDAR rulebook, mission brief and reference material.
    [arm_A_x2.stl, arm_B_x2.stl, arm_x4.stl, bottom_deck_x1.stl, bottom_plate_x1.stl, camera_mount_x1.stl, canopy_x1.stl, guard_arc_x16.stl]
2026-11-05 Add STEP solids and SOLIDWORKS conversion for all frame parts
    Adds a STEP file per printed part plus a deployed assembly for versions 1 and 2, the script that exports them from the design code, a SOLIDWORKS batch conversion macro, and an editing guide.
    [arm_A_x2.step, arm_B_x2.step, arm_x4.step, assembly_deployed.step, bottom_deck_x1.step, bottom_plate_x1.step, camera_mount_x1.step, canopy_x1.step]
2026-11-10 Add version 3 ZD550 generator and version 4 compact AirMouse frame
    [arm_root_A_x2.step, arm_root_A_x2.stl, arm_root_B_x2.step, arm_root_B_x2.stl, arm_tube_x4_BUY.step, assembly_deployed.step, battery_tray_x1.step, battery_tray_x1.stl]
2026-11-10 Add version 5 carbon fibre plate frame for NIDAR AirMouse
    [CUT_SHEET_2mm.dxf, CUT_SHEET_3mm.dxf, arm_side_3mm_x8.dxf, arm_side_3mm_x8.step, assembly_deployed.step, assembly_folded.step, bottom_plate_3mm_x1.dxf, bottom_plate_3mm_x1.step]
2026-11-10 Add version 6 X-layout plywood and aluminium frame for NIDAR AirMouse
    [CUT_SHEET_3mm.dxf, CUT_SHEET_4mm.dxf, arm_tube_x4.step, assembly_deployed.step, assembly_folded.step, bottom_plate_4mm_x1.dxf, bottom_plate_4mm_x1.step, camera_plate_3mm_x1.dxf]
